Monash-EPHM-Lab/Monash-BoSL/README.md

# Monash-BoSL
Monash-BoSL project repository

This repostory contains all the hardware and software resources for the BoSL board.

Find our website at: www.bosl.com.au

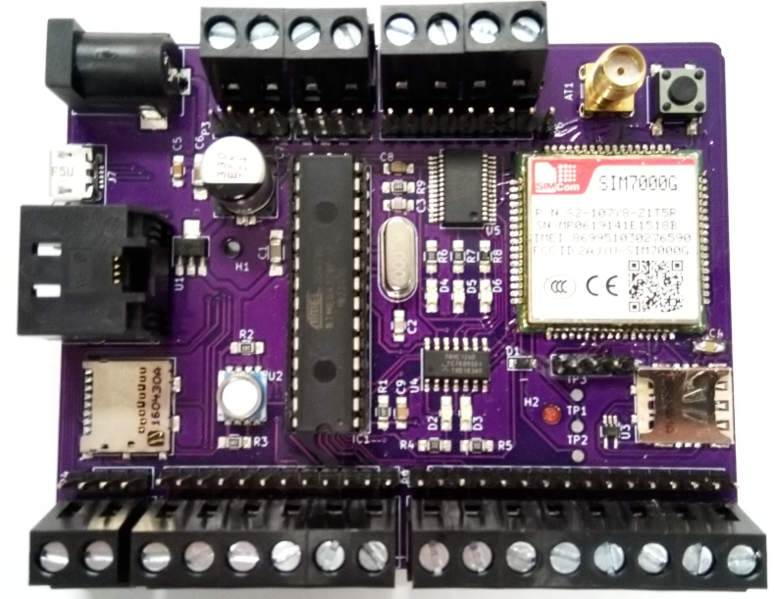
[picture p1: README.png]
BoSL Board
