Monash-EPHM-Lab/Monash-BoSL/Tasklist.txt

Branch Specific Tasklist

measure power consumption on everything and create file for it in documentation.

write code documentation
