Monash-EPHM-Lab/Monash-BoSL/Velocity/FFT/FFT.PNG

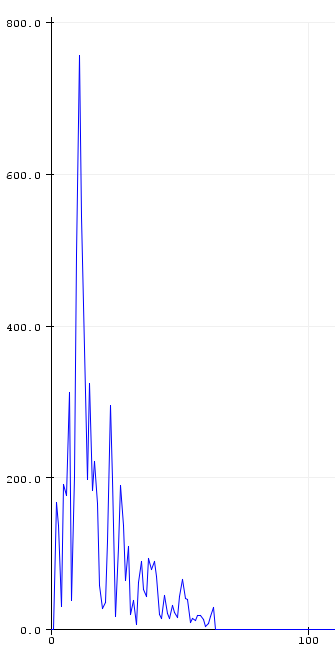
Velocity/FFT/FFT.PNG
