Monash-EPHM-Lab/Monash-BoSL/EDA/BoSL BOM Rev 0.4.1.xlsx

Part Number | Package Size / Type | Schematic Designator | Component | Value | QTY per board | Unit Price | Total Price | Supplier
DC Barrel Jack | 2.1mm | CON2 | DC Barrel Jack | 2.1mm | 1 | $0.50 | $0.50 | https://www.altronics.com.au/p/p0620-2.1mm-female-plastic-pcb-mount-dc-power-socket/
RJ45 Jack |  | J6 | Ethernet Connector |  | 1 | $1.50 | $1.50 | https://au.element14.com/amphenol-icc-commercial-products/rjhse-5080/jack-rj45-1port/dp/1860577?st=RJHSE-5080
Screw Terminals | 5mm pitch | J1 / J2 / J3 / J4 / J5 | Screw Terminals | 1x02 / 2x04 / 1x06 / 1x08 (24 Total) | 24 | $0.30 | $7.20 | https://www.digikey.com.au/product-detail/en/molex/0393570002/WM7877-ND/946543
MCP1700T-3302E | 3-Pin SOT-89 | U1 | Voltage Regulator |  | 1 | $0.60 | $0.60 | https://au.mouser.com/ProductDetail/Microchip-Technology/MCP1700T-3302E-MB
MS5803-01BA |  | U2 | Pressure / Temperature Sensor |  | 1 | $19.00 | $19.00 | https://www.digikey.com/products/es?mpart=MS580301BA01-00&v=223
105133-0001 | Micro | J7 | Micro USB Connector | Vertical | 1 | $0.80 | $0.80 | https://au.element14.com/molex/105133-0001/usb-conn-2-0-micro-usb-type-b/dp/2751682?st=micro usb
FT232RL | SSOP-28 (5.3mm) | U5 | UART to Serial Converter |  | 1 | $4.00 | $4.00 | https://au.mouser.com/ProductDetail/FTDI/FT232RL-REEL?qs=D1%2FPMqvA103RC6OU6bKtoA%3D%3D
74HC126 | SIOC-14 (1.27 mm pitch) | U4 | Quad Tristate Buffer |  | 1 | $0.77 | $0.77 | https://au.element14.com/nexperia/74hc126d/ic-74hc-cmos-smd-74hc126-soic14/dp/1085233?st=74HC126
Any Applicable | 1206 | C1 / C6 | SMD Capacitor | 1 uF | 2 | $0.10 | $0.20
Any Applicable | 0805 | C2 / C3 | SMD Capacitor | 22 pF | 2 | $0.10 | $0.20
Any Applicable | 0805 | C4 | SMD Capacitor | 220 pF | 1 | $0.10 | $0.10
UWT1E331MNL1GS / OR Any Applicable | SMD:CP_Elec_8x10 | C7 | SMD Capacitor | 330 uF | 1 | $0.10 | $0.10 | https://au.mouser.com/ProductDetail/Nichicon/UWT1E331MNL1GS
Any Applicable | 0805 | C5 / C8 / C9 | SMD Capacitor | 100 nF | 3 | $0.10 | $0.30
Any Applicable | 0805 | R1 / R2 / R3 / R9 | SMD Resistor | 10 kΩ | 4 | $0.10 | $0.40
Any Applicable | 0805 | R4 / R5 / R6 / R7 / R8 | SMD Resistor | 3.3 kΩ | 5 | $0.10 | $0.50
1N4148 | D_SOD-323 | D1 | SMD Diode |  | 1 | $0.10 | $0.10
Any Applicable | 0805 | D2 | SMD LED | BLUE | 1 | $0.10 | $0.10
Any Applicable | 0805 | D3 / D4 | SMD LED | RED | 2 | $0.10 | $0.20
Any Applicable | 0805 | D5 | SMD LED | YELLOW | 2 | $0.10 | $0.20
Any Applicable | 0805 | D6 | SMD LED | GREEN | 2 | $0.10 | $0.20
MSQA6V1W5T2G | SOT-353_SC-70-5 | U3 | ESD Protection Diode Array |  | 1 | $1.00 | $1.00 | https://www.digikey.com.au/product-detail/en/on-semiconductor/MSQA6V1W5T2G/MSQA6V1W5T2GOSCT-ND/1967206
Any Applicable | SMD | SW1 | SPST switch |  | 1 | $0.50 | $0.50 | https://www.altronics.com.au/p/s1112a-spst-momentary-smd-4.3mm-tactile-switch/
ECS-80-18-30-JGN-TR | 2-SMD | Y1 | Crystal | 8MHz | 1 | $0.69 | $0.69 | https://www.digikey.com/product-detail/en/ecs-inc/ECS-80-18-30-JGN-TR/XC2103CT-ND/5875587
SIM7000G |  | IC2 | SIM7000 |  | 1 | $19.00 | $19.00 | https://www.aliexpress.com/item/32963816626.html
SIM Card Holder | Nano SIM | I1 | SIM Card Holder |  | 1 | $1.50 | $1.50 | https://au.mouser.com/ProductDetail/Molex/104224-0820
ATMEGA328P-AU | QTFN-32 | U6 | AT Mega 328 P-au |  | 1 | $2.16 | $2.16 | https://www.digikey.com.au/product-detail/en/microchip-technology/ATMEGA328P-AUR/ATMEGA328P-AURCT-ND/3789455
104031-0811 Molex |  | CON1 | microSD connector |  | 1 | $2.50 | $2.50 | https://au.mouser.com/ProductDetail/Molex/104031-0811?qs=sGAEpiMZZMuJakaoiLiBpj1mGp1aVlb8QxJnovvyiw8%3D
 | 0.1 inch pitch | J8 / J9 / J10 / P2 / P3 / P4 | Pin Headers | 3x04 / 1x05 / 1x6 / 1x8
212570-0100 |  | - | GNSS/GSM Antenna |  | 2 | $2.34 | $4.68 | https://au.element14.com/molex/212570-0100/cellular-lte-antenna-2-17ghz-1/dp/326166101?st=antenna
Any Applicable |  | C10 | SMD Capacitor | 33 pF | 1 | $0.10 | $0.10
Any Applicable | 0805 | C11,12 | SMD Capacitor | 12 pF | 2 | $0.10 | $0.20
MCP7940NT-I/SN |  | U7 | RTC Module |  | 1 | $0.74 | $0.74 | https://www.digikey.in/product-detail/en/microchip-technology/MCP7940NT-I-SN/MCP7940NT-I-SNCT-ND/5818704
FC-135 32.7680KA-AG5 |  | Y2 | Crystal | 32.768 kHz | 1 | $0.43 | $0.43 | https://www.digikey.com.au/product-detail/en/epson/FC-135-32-7680KA-AG5/SER4271CT-ND/7932258
2996TR |  | BT1 | Battery Clip |  | 1 | $0.63 | $0.63 | https://www.digikey.com.au/product-detail/en/keystone-electronics/2996TR/36-2996CT-ND/5878110
 | LR44 |  | Button Cell Battery | 1.5 V | 1 | $0.56 | $0.56 | https://www.digikey.com.au/product-detail/en/murata-electronics/LR44/490-18190-ND/9859017
 |  | AT2, AT3 | U.FL Antenna Connector |  | 2 | $0.34 | $0.68 | https://au.mouser.com/ProductDetail/TE-Connectivity/2337019-1
