Monash-EPHM-Lab/Monash-BoSL/Velocity/250kHz/Membrane.stl

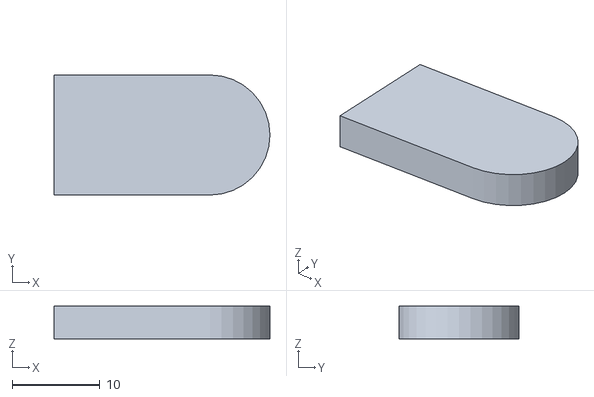
[picture p3: CAD file, 2019-12-09]
Velocity/250kHz/Membrane.stl
24.6 x 13.6 x 3.75
