Monash-EPHM-Lab/Monash-BoSL/Velocity/CAD/Velocity Holder.stl

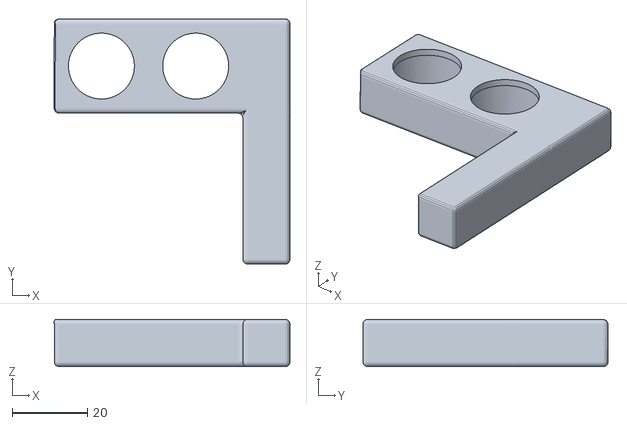
[picture p4: CAD file, 2019-12-10]
Velocity/CAD/Velocity Holder.stl
62.6 x 65.0 x 12.5
