Monash-EPHM-Lab/Monash-BoSL/(list of files, cad)

Other CAD files:
Velocity/250kHz/Membrane.blend
Velocity/CAD/Velocity Holder.blend
Water-Probe/Design Files/CAD/Probe Body Square.blend
