Monash-EPHM-Lab/Monash-BoSL/Documentation/BoSL Battery Log Test.xlsx

Date | Battery (V)
2019-09-26 | 4.05
2019-10-03 | 4.01
2019-10-10 | 3.93
2019-10-17 | 3.9
