Monash-EPHM-Lab/Monash-BoSL/Documentation/Battery Testing/Battery Data.xlsx

BAT 70953 | Temp | EC | Water | Bat | Air | count
2019-12-18 21:16 | -30762 | 183 | 68555 | 4238 | 100676 | 1
2019-12-18 21:18 | -30762 | 183 | 68555 | 4237 | 100553 | 2
2019-12-18 21:21 | -30762 | 183 | 68555 | 4235 | 100709 | 3
2019-12-18 21:23 | -30762 | 183 | 68555 | 4235 | 100688 | 4
2019-12-18 21:26 | -30762 | 176 | 68555 | 4236 | 100700 | 5
2019-12-18 21:28 | 2280 | 1023 | 102059 | 4233 | 100706 | 6
2019-12-18 21:31 | 2279 | 1023 | 102062 | 4232 | 100779 | 7
2019-12-18 21:33 | 2276 | 1023 | 102061 | 4233 | 100773 | 8
2019-12-18 21:36 | 2271 | 1023 | 102073 | 4232 | 100760 | 9
2019-12-18 21:38 | 2267 | 1023 | 102072 | 4231 | 100513 | 10
2019-12-18 21:41 | 2263 | 1023 | 102063 | 4231 | 100821 | 11
2019-12-18 21:43 | 2261 | 1023 | 102065 | 4231 | 100833 | 12
2019-12-18 21:46 | 2258 | 1023 | 102062 | 4230 | 100774 | 13
2019-12-18 21:48 | 2255 | 1023 | 102052 | 4229 | 100798 | 14
2019-12-18 21:51 | 2253 | 1023 | 102042 | 4228 | 100758 | 15
2019-12-18 21:53 | 2251 | 1023 | 102037 | 4229 | 100699 | 16
2019-12-18 21:56 | 2250 | 1023 | 102055 | 4228 | 100739 | 17
2019-12-18 21:58 | -30762 | 180 | 68555 | 4230 | 100801 | 18
2019-12-18 22:01 | -30762 | 179 | 68555 | 4229 | 100753 | 19
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
