Monash-EPHM-Lab/Monash-BoSL/Documentation/Battery Testing/Raw Data/BOSL_BAT_70953.csv

This is our new file for site: BOSL_BAT_70953.csv. We will write Date and time in first column | temperature in the next | EC | then depth
09/12/19 11:25:13 PM | -30762 | 188 | 68555 | 4020 | 100748
18/12/19 09:16:20 PM | -30762 | 183 | 68555 | 4238 | 100676
18/12/19 09:18:49 PM | -30762 | 183 | 68555 | 4237 | 100553
18/12/19 09:21:19 PM | -30762 | 183 | 68555 | 4235 | 100709
18/12/19 09:23:48 PM | -30762 | 183 | 68555 | 4235 | 100688
18/12/19 09:26:17 PM | -30762 | 176 | 68555 | 4236 | 100700
18/12/19 09:28:47 PM | 2280 | 1023 | 102059 | 4233 | 100706
18/12/19 09:31:16 PM | 2279 | 1023 | 102062 | 4232 | 100779
18/12/19 09:33:45 PM | 2276 | 1023 | 102061 | 4233 | 100773
18/12/19 09:36:15 PM | 2271 | 1023 | 102073 | 4232 | 100760
18/12/19 09:38:45 PM | 2267 | 1023 | 102072 | 4231 | 100513
18/12/19 09:41:14 PM | 2263 | 1023 | 102063 | 4231 | 100821
18/12/19 09:43:43 PM | 2261 | 1023 | 102065 | 4231 | 100833
18/12/19 09:46:13 PM | 2258 | 1023 | 102062 | 4230 | 100774
18/12/19 09:48:43 PM | 2255 | 1023 | 102052 | 4229 | 100798
18/12/19 09:51:13 PM | 2253 | 1023 | 102042 | 4228 | 100758
18/12/19 09:53:43 PM | 2251 | 1023 | 102037 | 4229 | 100699
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
