Monash-EPHM-Lab/Monash-BoSL/Documentation/SIM Recognition Issue/SIM Lines/GOOD DATA SIM.jpg

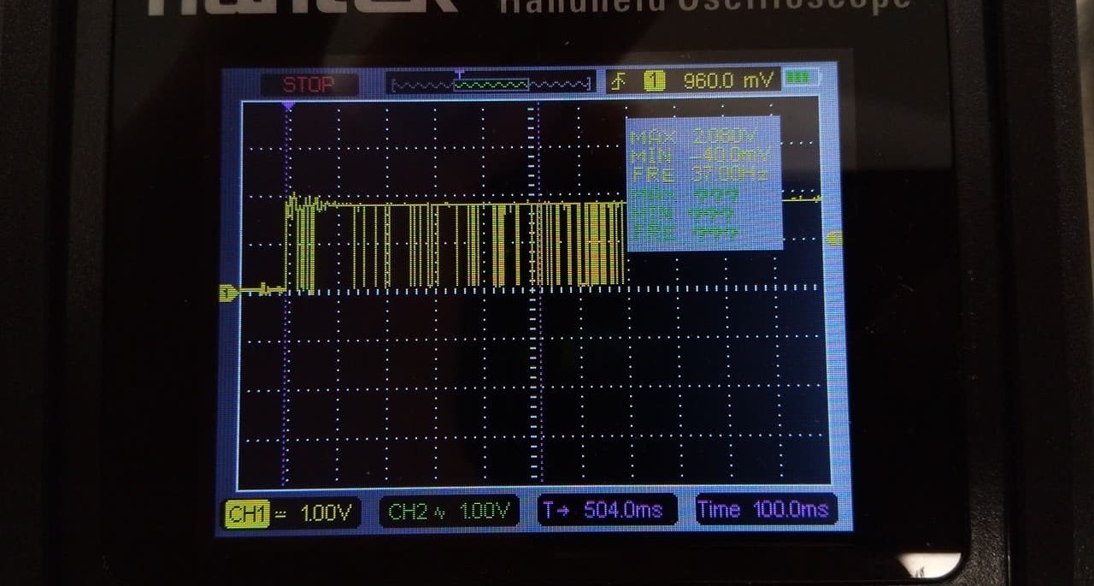
Documentation/SIM Recognition Issue/SIM Lines/GOOD DATA SIM.jpg
