Monash-EPHM-Lab/Monash-BoSL/EDA/BoSL rev0.4.1 schematic.pdf

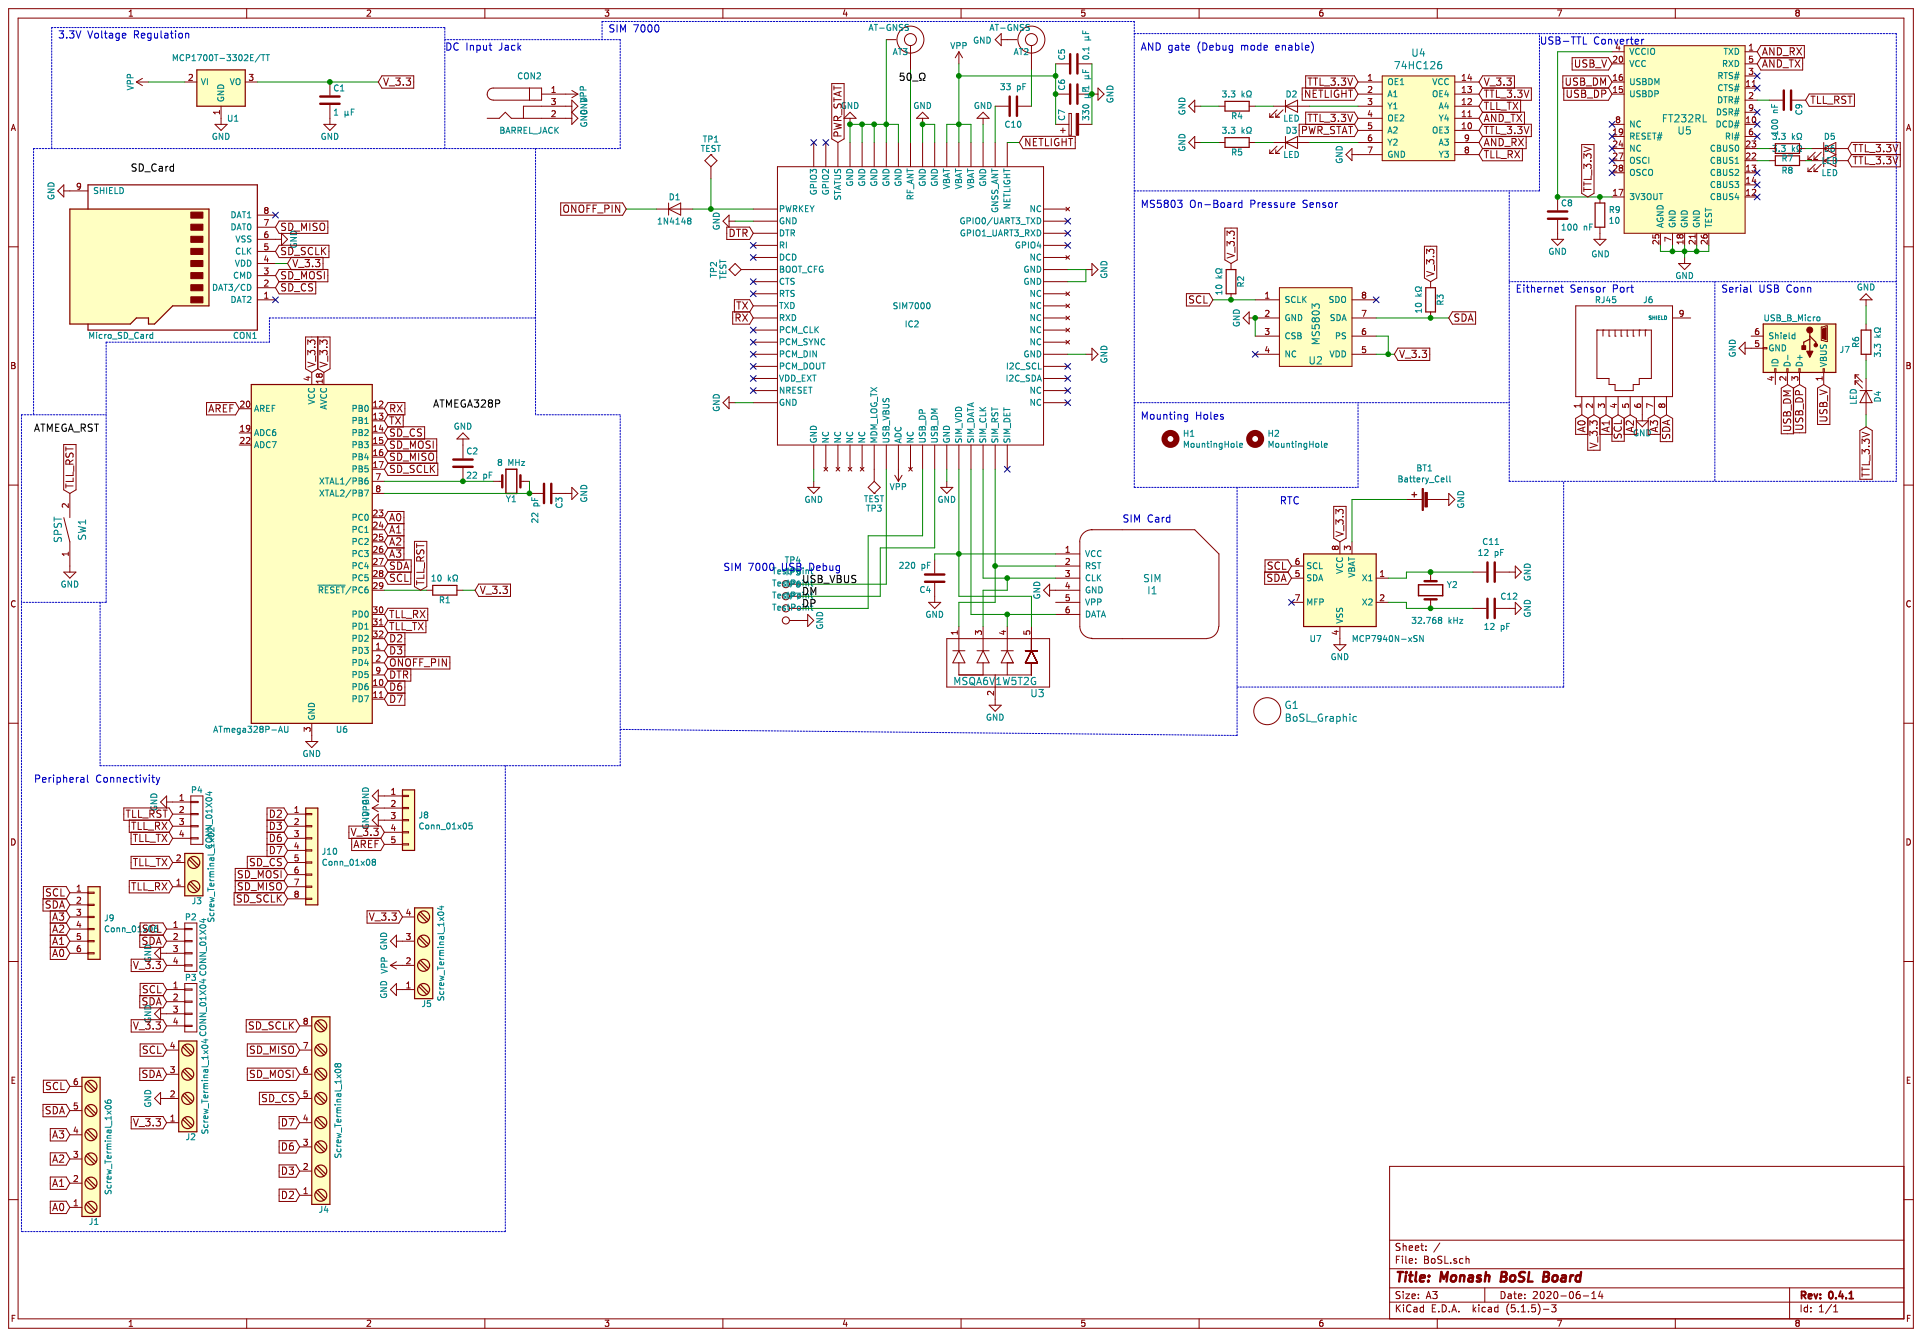
[picture p20: page 1]
