Monash-EPHM-Lab/Monash-BoSL/(list of files, drawings)

Other design files:
EDA/EDA/BoSL.dsn
