Monash-EPHM-Lab/Monash-BoSL/EDA/EDA/BoSL.kicad_pcb

## KiCad design EDA/EDA/BoSL.kicad_pcb (2020-08-11)

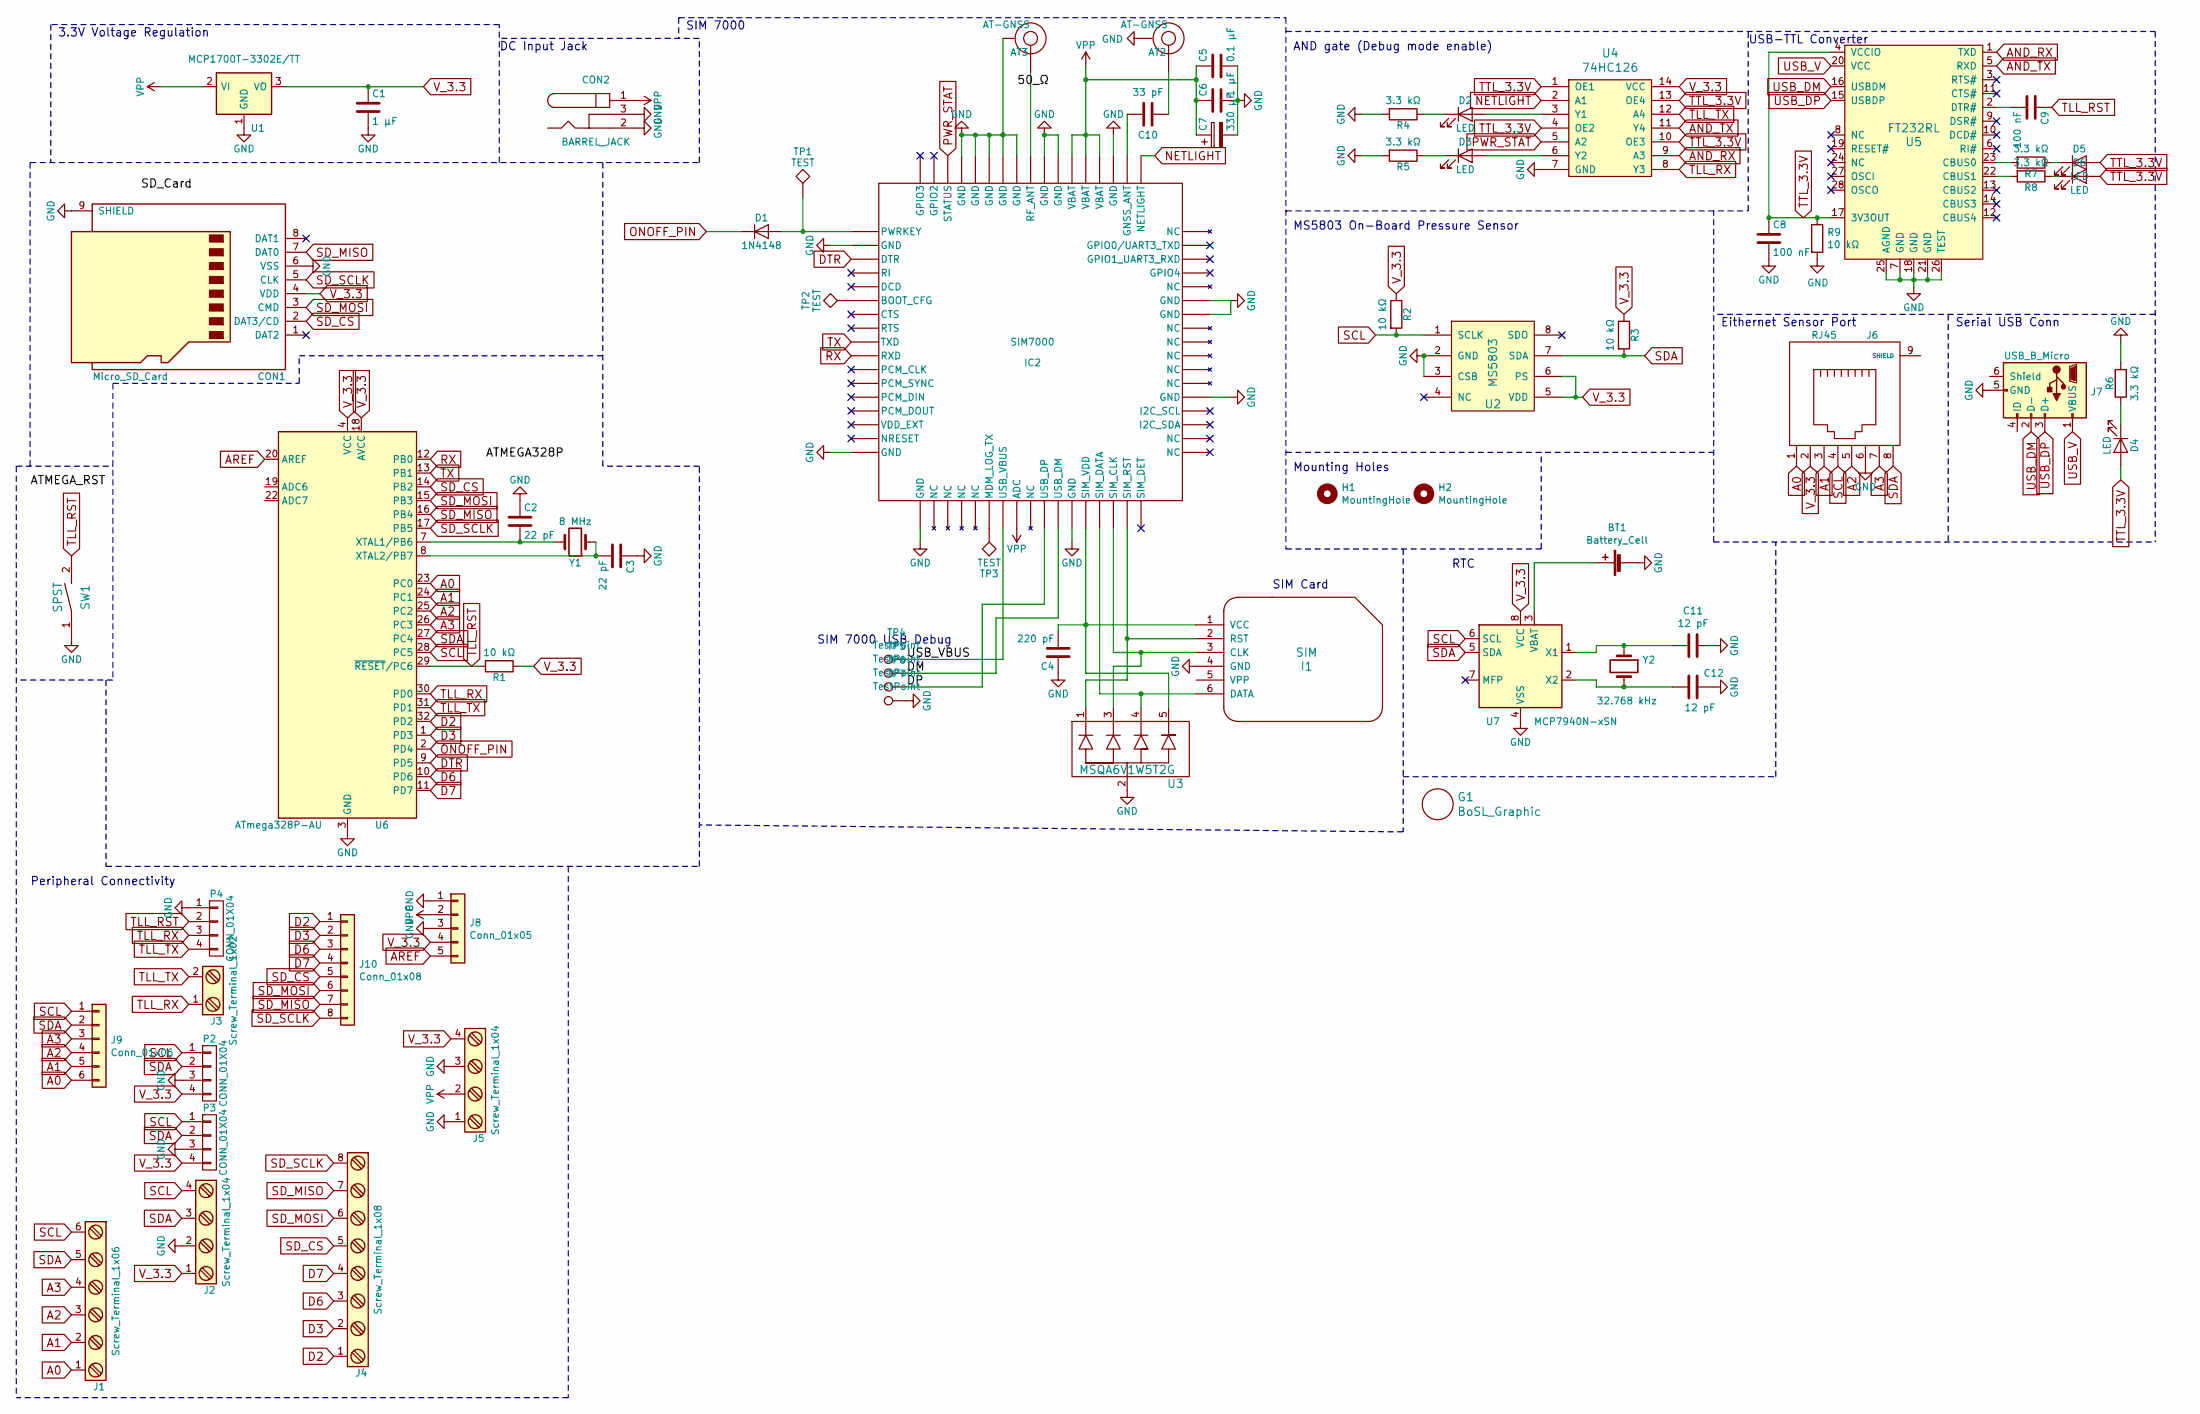
[picture p21: schematic BoSL.sch, Monash BoSL Board]

Parts:
AT2, AT3: AT-GNSS; U.FL_Molex_MCRF_73412-0110_Vertical
BT1: Battery_Cell; 2996TR
C1, C6: 1 μF; C_1206_3216Metric
C2, C3: 22 pF; C_0805_2012Metric
C4: 220 pF; C_0805_2012Metric
C5: 0.1 μF; C_0805_2012Metric
C7: 330 μF; CP_Elec_8x10
C8, C9: 100 nF; C_0805_2012Metric
C10: 33 pF; C_0805_2012Metric
C11, C12: 12 pF; C_0805_2012Metric
CON1: Micro_SD_Card; microSD_Connector
CON2: BARREL_JACK; BarrelJack_Horizontal
D1: 1N4148; D_SOD-323
D2, D3, D4, D5, D6: LED; LED_0805_2012Metric
G1: BoSL_Graphic
H1, H2: MountingHole; MountingHole_2.2mm_M2_Pad
I1: SIM; SIMNano
IC2: SIM7000
J1: Screw_Terminal_1x06; TerminalBlock_Phoenix_PT-1,5-6-3.5-H_1x06_P3.50mm_Horizontal
J2, J5: Screw_Terminal_1x04; TerminalBlock_Phoenix_PT-1,5-4-3.5-H_1x04_P3.50mm_Horizontal
J3: Screw_Terminal_1x02; TerminalBlock_Phoenix_PT-1,5-2-3.5-H_1x02_P3.50mm_Horizontal
J4: Screw_Terminal_1x08; TerminalBlock_Phoenix_PT-1,5-8-3.5-H_1x08_P3.50mm_Horizontal
J6: RJ45; RJ_45
J7: USB_B_Micro; USB_Micro-B_Molex-105133-0001
J8: Conn_01x05; PinHeader_1x05_P2.54mm_Vertical
J9: Conn_01x06; PinHeader_1x06_P2.54mm_Vertical
J10: Conn_01x08; PinHeader_1x08_P2.54mm_Vertical
P2, P3, P4: CONN_01X04; PinHeader_1x04_P2.54mm_Vertical
R1, R2, R3, R9: 10 kΩ; R_0805_2012Metric
R4, R5, R6, R7, R8: 3.3 kΩ; R_0805_2012Metric
SW1: SPST; SW_SPST_B3S-1000
TP1, TP2, TP3: TEST; TestPoint_Pad_D1.0mm
TP4, TP5, TP6, TP7: TestPoint; TestPoint_Pad_1.5x1.5mm
U1: MCP1700T-3302E/TT; SOT-89-3
U2: MS5803
U3: MSQA6V1W5T2G; SOT-353_SC-70-5
U4: 74HC126; SOIC-14_3.9x8.7mm_P1.27mm
U5: FT232RL; SSOP-28_5.3x10.2mm_P0.65mm
U6: ATmega328P-AU; TQFP-32_7x7mm_P0.8mm
U7: MCP7940N-xSN; SOIC-8_3.9x4.9mm_P1.27mm
Y1: 8 MHz; Crystal_SMD_5032-2Pin_5.0x3.2mm
Y2: 32.768 kHz; Crystal_SMD_EuroQuartz_EQ161-2Pin_3.2x1.5mm

Connections:
/DM: IC2.28 (USB_DM), TP5.1
/DP: IC2.27 (USB_DP), TP6.1
/USB_VBUS: IC2.24 (USB_VBUS), TP4.1
A0: J1.1, J6.1, J9.6, U6.23 (PC0)
A1: J1.2, J6.3, J9.5, U6.24 (PC1)
A2: J1.3, J6.5, J9.4, U6.25 (PC2)
A3: J1.4, J6.7, J9.3, U6.26 (PC3)
AND_RX: U4.9 (A3), U5.1 (TXD)
AND_TX: U4.11 (Y4), U5.5 (RXD)
AREF: J8.5, U6.20 (AREF)
D2: J4.1, J10.1, U6.32 (PD2)
D3: J4.2, J10.2, U6.1 (PD3)
D6: J4.3, J10.3, U6.10 (PD6)
D7: J4.4, J10.4, U6.11 (PD7)
DTR: IC2.3 (DTR), U6.9 (PD5)
GND: AT2.2, AT3.2, BT1.2 (-), C1.2, C2.1, C3.1, C4.1, C5.2, C6.2, C7.2, C8.2, C11.1, C12.1, CON1.6 (VSS), CON1.9 (SHIELD), CON2.2, CON2.3, I1.4 (GND), IC2.2 (GND), IC2.17 (GND), IC2.18 (GND), IC2.29 (GND), IC2.39 (GND), IC2.45 (GND), IC2.46 (GND), IC2.54 (GND), IC2.58 (GND), IC2.59 (GND), IC2.61 (GND), IC2.62 (GND), IC2.63 (GND), IC2.64 (GND), IC2.65 (GND), J2.2, J5.1, J5.3, J6.6, J7.5 (GND), J8.1, J8.3, P2.3, P3.3, P4.1, R4.2, R5.2, R6.2, R9.2, SW1.1, TP7.1, U1.1 (GND), U2.2 (GND), U2.3 (CSB), U3.2, U4.7 (GND), U5.7 (GND), U5.18 (GND), U5.21 (GND), U5.25 (AGND), U5.26 (TEST), U6.3 (GND), U6.5 (GND), U6.21 (GND), U7.4 (VSS)
NETLIGHT: IC2.52 (NETLIGHT), U4.2 (A1)
unnamed: AT2.1, C10.1
unnamed: AT3.1, IC2.60 (RF_ANT)
unnamed: BT1.1 (+), U7.3 (VBAT)
unnamed: C2.2, U6.7 (XTAL1/PB6), Y1.2
unnamed: C3.2, U6.8 (XTAL2/PB7), Y1.1
unnamed: C4.2, I1.1 (VCC), IC2.30 (SIM_VDD), U3.5
unnamed: C9.2, U5.2 (DTR#)
unnamed: C10.2, IC2.53 (GNSS_ANT)
unnamed: C11.2, U7.1 (X1), Y2.1
unnamed: C12.2, U7.2 (X2), Y2.2
unnamed: D1.2 (A), IC2.1 (PWRKEY), TP1.1
unnamed: D2.1 (K), R4.1
unnamed: D2.2 (A), U4.3 (Y1)
unnamed: D3.1 (K), R5.1
unnamed: D3.2 (A), U4.6 (Y2)
unnamed: D4.1 (K), R6.1
unnamed: D5.1 (K), R7.1
unnamed: D6.1 (K), R8.1
unnamed: I1.2 (RST), IC2.33 (SIM_RST), U3.1
unnamed: I1.3 (CLK), IC2.32 (SIM_CLK), U3.3
unnamed: I1.6 (DATA), IC2.31 (SIM_DATA), U3.4
unnamed: IC2.6 (BOOT_CFG), TP2.1
unnamed: IC2.23 (MDM_LOG_TX), TP3.1
unnamed: R7.2, U5.23 (CBUS0)
unnamed: R8.2, U5.22 (CBUS1)
ONOFF_PIN: D1.1 (K), U6.2 (PD4)
PWR_STAT: IC2.66 (STATUS), U4.5 (A2)
RX: IC2.10 (RXD), U6.12 (PB0)
SCL: J1.6, J2.4, J6.4, J9.1, P2.1, P3.1, R2.2, U2.1 (SCLK), U6.28 (PC5), U7.6 (SCL)
SDA: J1.5, J2.3, J6.8, J9.2, P2.2, P3.2, R3.2, U2.7 (SDA), U6.27 (PC4), U7.5 (SDA)
SD_CS: CON1.2 (DAT3/CD), J4.5, J10.5, U6.14 (PB2)
SD_MISO: CON1.7 (DAT0), J4.7, J10.7, U6.16 (PB4)
SD_MOSI: CON1.3 (CMD), J4.6, J10.6, U6.15 (PB3)
SD_SCLK: CON1.5 (CLK), J4.8, J10.8, U6.17 (PB5)
TLL_RST: C9.1, P4.2, R1.2, SW1.2, U6.29 (~RESET~/PC6)
TLL_RX: J3.1, P4.3, U4.8 (Y3), U6.30 (PD0)
TLL_TX: J3.2, P4.4, U4.12 (A4), U6.31 (PD1)
TTL_3.3V: C8.1, D4.2 (A), D5.2 (A), D6.2 (A), R9.1, U4.1 (OE1), U4.4 (OE2), U4.10 (OE3), U4.13 (OE4), U5.4 (VCCIO), U5.17 (3V3OUT)
TX: IC2.9 (TXD), U6.13 (PB1)
USB_DM: J7.2 (D-), U5.16 (USBDM)
USB_DP: J7.3 (D+), U5.15 (USBDP)
USB_V: J7.1 (VBUS), U5.20 (VCC)
VPP: C5.1, C6.1, C7.1, CON2.1, IC2.25 (ADC), IC2.55 (VBAT), IC2.56 (VBAT), IC2.57 (VBAT), J5.2, J8.2, U1.2 (VI)
V_3.3: C1.1, CON1.4 (VDD), J2.1, J5.4, J6.2, J8.4, P2.4, P3.4, R1.1, R2.1, R3.1, U1.3 (VO), U2.5 (VDD), U2.6 (PS), U4.14 (VCC), U6.4 (VCC), U6.6 (VCC), U6.18 (AVCC), U7.8 (VCC)

Notes on the sheet:
3.3V Voltage Regulation
DC Input Jack
SIM 7000
SIM Card
SIM 7000 USB Debug
AND gate (Debug mode enable)
USB-TTL Converter
Serial USB Conn
Eithernet Sensor Port
MS5803 On-Board Pressure Sensor
Peripheral Connectivity
Mounting Holes
RTC

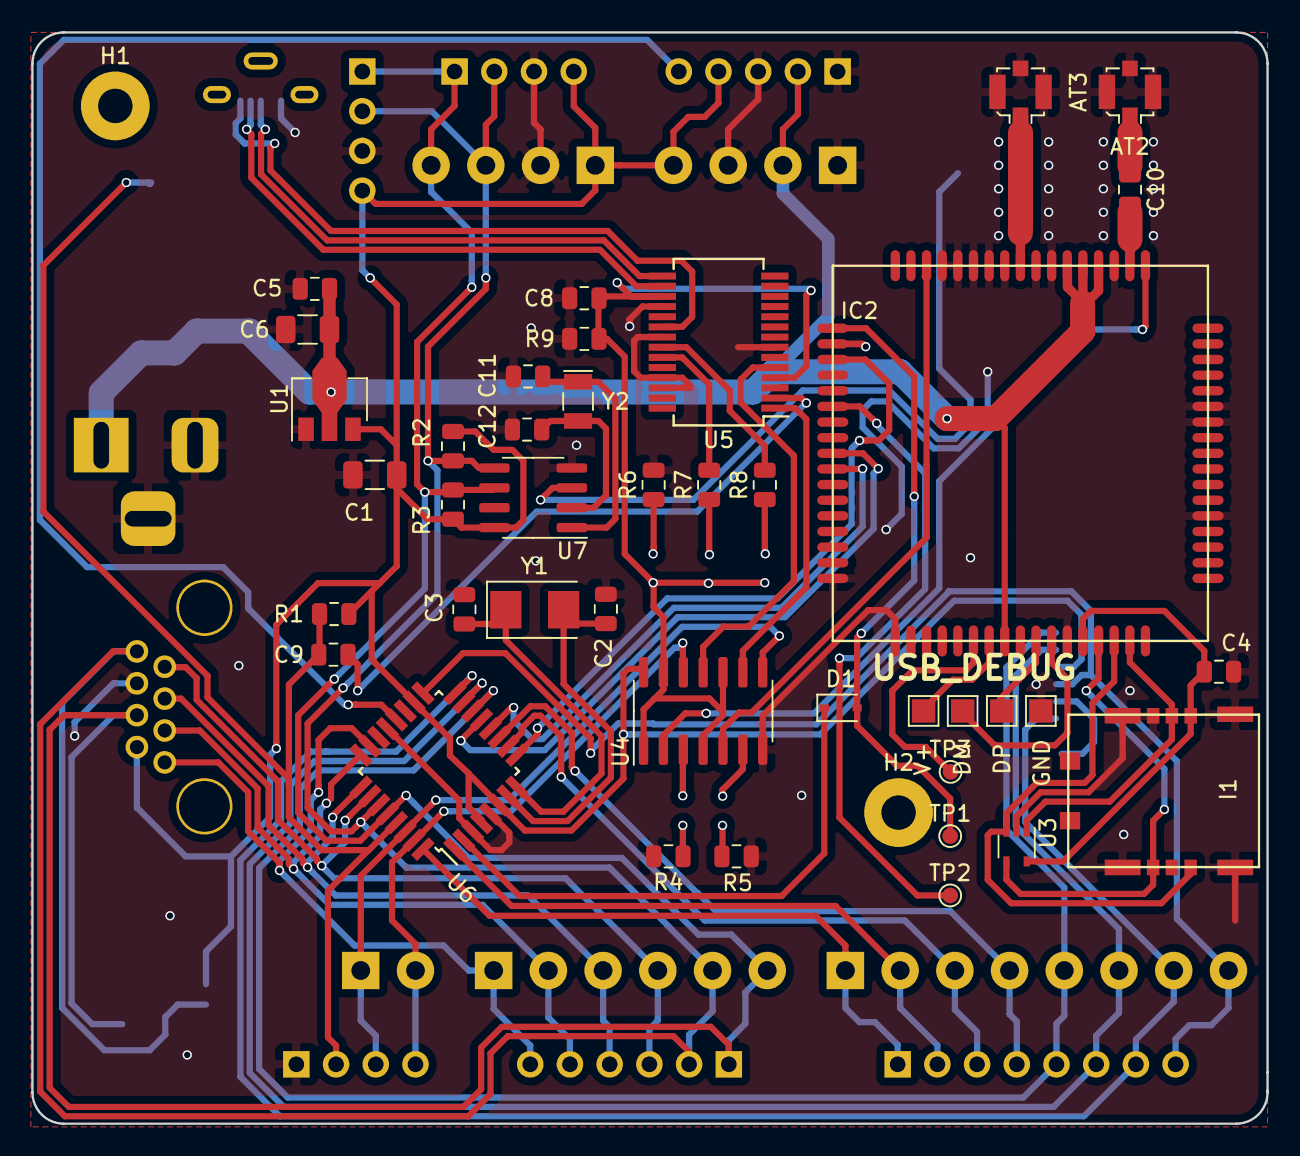
[picture p22: board BoSL.kicad_pcb from above]

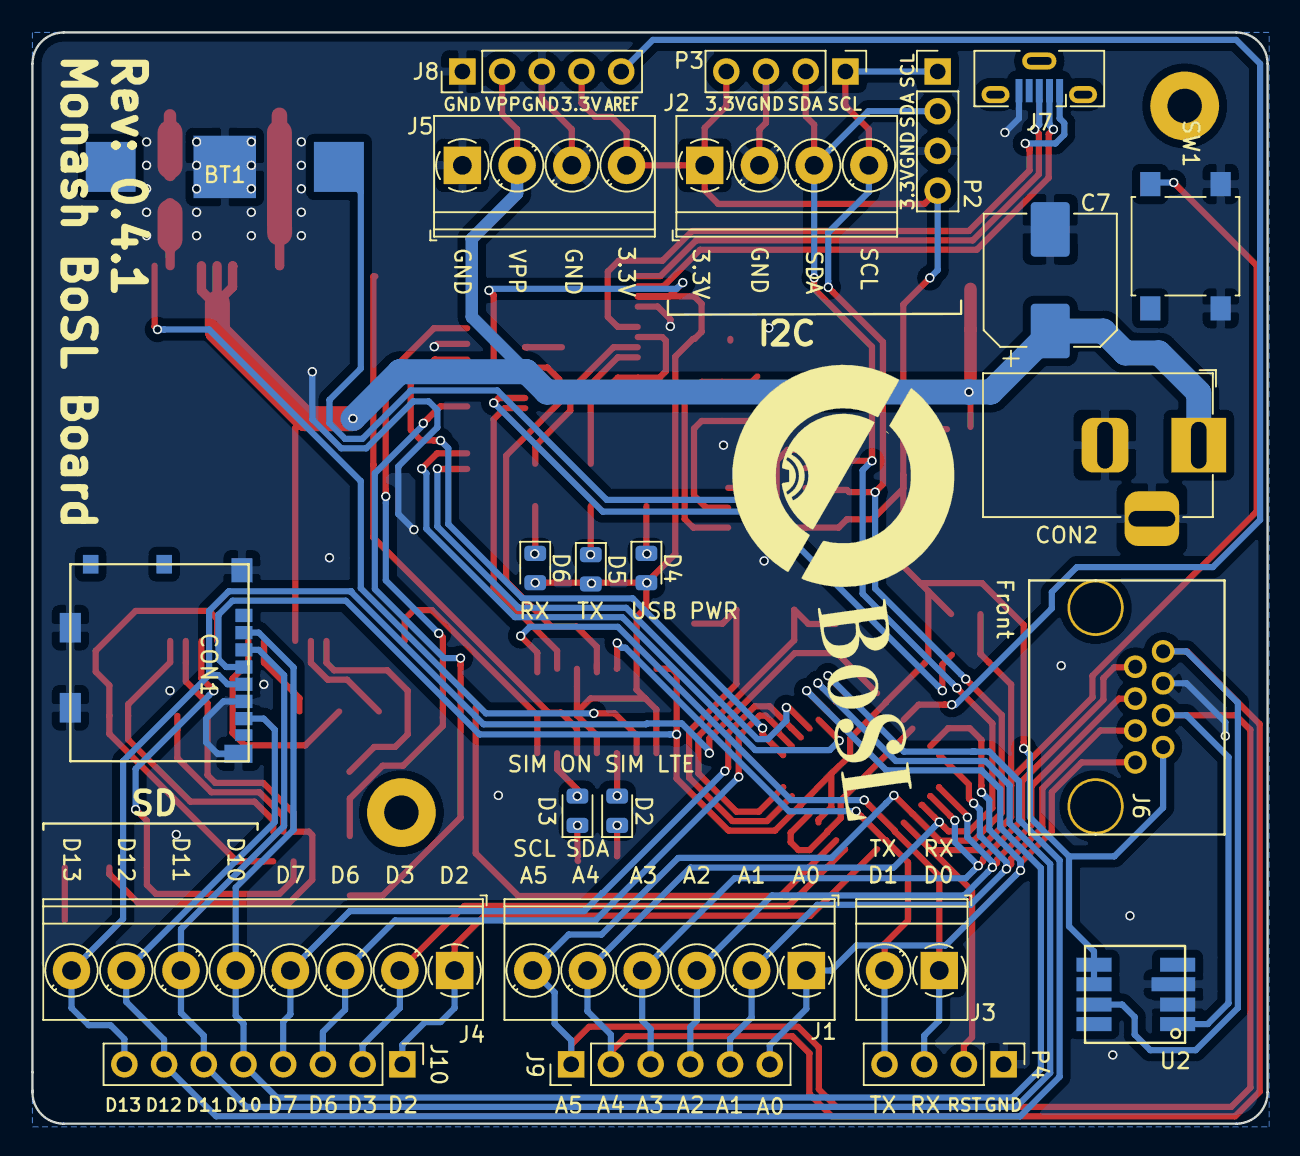
[picture p23: board BoSL.kicad_pcb from below]

Board: 2 copper layers, 79.0 x 69.8 mm, 67 parts (25 on the bottom side), 61 nets.
