Monash-EPHM-Lab/Monash-BoSL/Velocity/AM Demodulator/AM Demodulator/AM Demodulator.kicad_pcb

## KiCad design Velocity/AM Demodulator/AM Demodulator/AM Demodulator.kicad_pcb (2019-12-09)

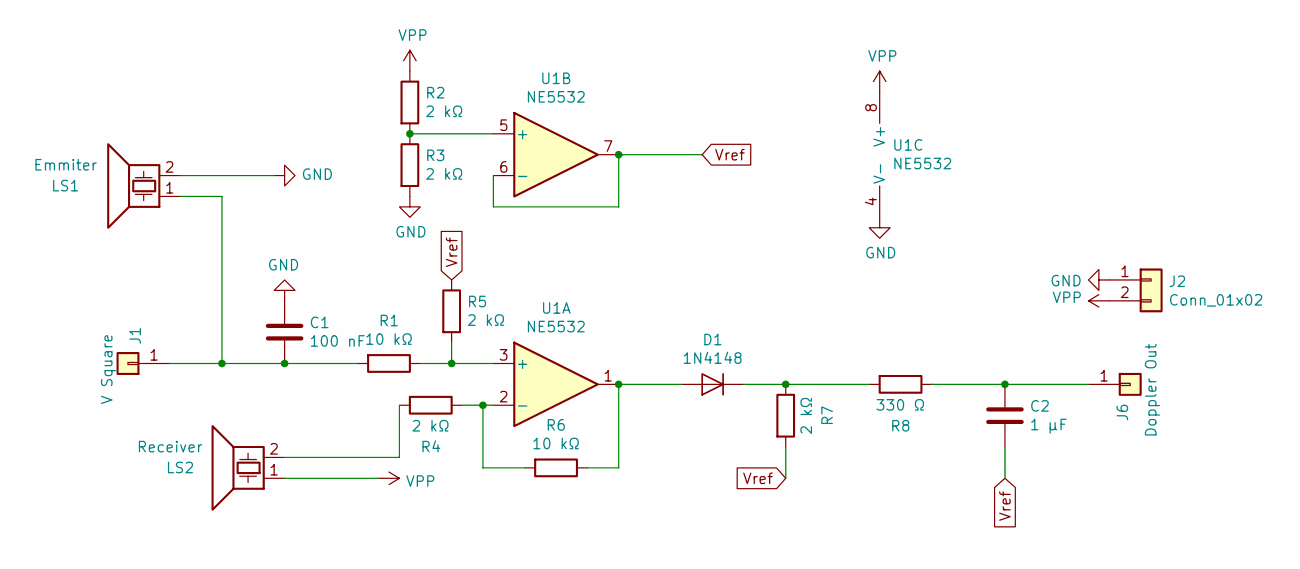
[picture p24: schematic AM Demodulator.sch, Velocity AM Demodulator]

Parts:
C1: 100 nF; CP_Radial_D5.0mm_P2.50mm
C2: 1 μF; CP_Radial_D5.0mm_P2.50mm
D1: 1N4148; D_A-405_P7.62mm_Horizontal
J1: V Square; Pin_Header_Straight_1x01_Pitch2.54mm
J2: Conn_01x02; Pin_Header_Straight_1x02_Pitch2.54mm
J6: Doppler Out; Pin_Header_Straight_1x01_Pitch2.54mm
LS1: Emmiter; Pin_Header_Straight_1x02_Pitch2.54mm
LS2: Receiver; Pin_Header_Straight_1x02_Pitch2.54mm
R1, R6: 10 kΩ; R_Axial_DIN0204_L3.6mm_D1.6mm_P7.62mm_Horizontal
R2, R3, R4, R5, R7: 2 kΩ; R_Axial_DIN0204_L3.6mm_D1.6mm_P7.62mm_Horizontal
R8: 330 Ω; R_Axial_DIN0204_L3.6mm_D1.6mm_P7.62mm_Horizontal
U1: NE5532; DIP-8_W7.62mm_LongPads

Connections:
GND: C1.1, J2.1, LS1.2, R3.2, U1.4 (V-)
unnamed: C1.2, J1.1, LS1.1, R1.2
unnamed: C2.1, J6.1, R8.1
unnamed: D1.1 (K), R7.1, R8.2
unnamed: D1.2 (A), R6.1, U1.1
unnamed: LS2.2, R4.2
unnamed: R1.1, R5.2, U1.3 (+)
unnamed: R2.2, R3.1, U1.5 (+)
unnamed: R4.1, R6.2, U1.2 (-)
VPP: J2.2, LS2.1, R2.1, U1.8 (V+)
Vref: C2.2, R5.1, R7.2, U1.6 (-), U1.7

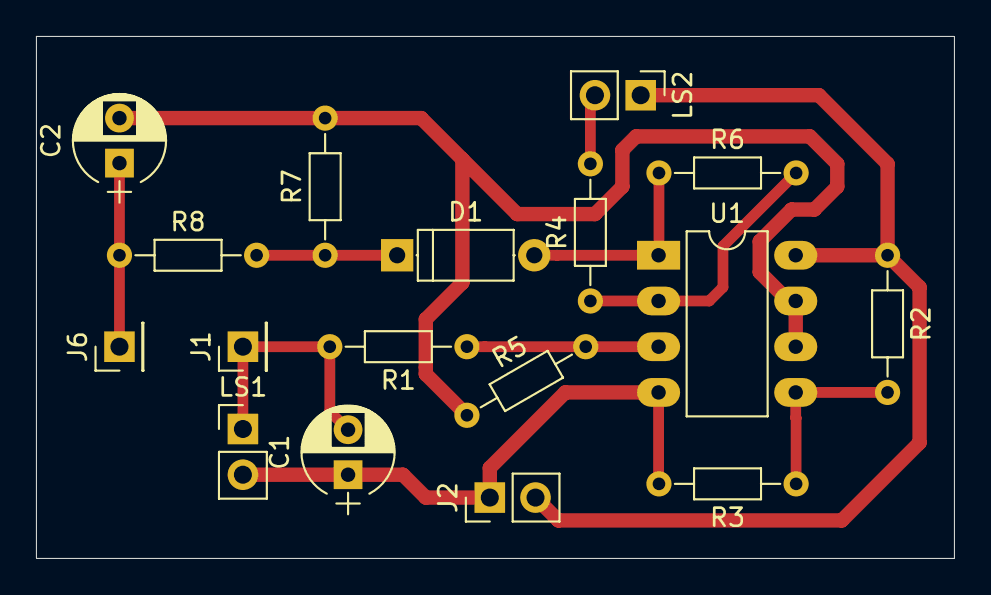
[picture p25: board AM Demodulator.kicad_pcb from above]

Board: 2 copper layers, 51.0 x 29.0 mm, 17 parts (0 on the bottom side), 11 nets.
