Monash-EPHM-Lab/Monash-BoSL/Code/BoSL-lib/SIM7000.h

/***************************************************
  This is a library for our Adafruit FONA Cellular Module

  Designed specifically to work with the Adafruit FONA
  ----> http://www.adafruit.com/products/1946
  ----> http://www.adafruit.com/products/1963

  These displays use TTL Serial to communicate, 2 pins are required to
  interface
  Adafruit invests time and resources providing this open source code,
  please support Adafruit and open-source hardware by purchasing
  products from Adafruit!

  Written by Limor Fried/Ladyada for Adafruit Industries.
  BSD license, all text above must be included in any redistribution
 ****************************************************/
#ifndef SIM7000_H
#define SIM7000_H

#include "includes/FONAConfig.h"
#include "includes/FONAExtIncludes.h"
#include "includes/platform/FONAPlatform.h"


#define FONA_DEFAULT_TIMEOUT_MS 500

#define FONA_HTTP_GET   0
#define FONA_HTTP_POST  1
#define FONA_HTTP_HEAD  2


class SIM7000 : public FONAStreamType {
 public:
  SIM7000(void);

  boolean begin(FONAStreamType &port);

  // Stream
  int available(void);
  size_t write(uint8_t x);
  int read(void);
  int peek(void);
  void flush();

  // Power, battery, and ADC
  boolean powerDown(void);
  boolean getADCVoltage(uint16_t *v);
  boolean getBattPercent(uint16_t *p);
  boolean getBattVoltage(uint16_t *v);

  // Functionality and operation mode settings
  boolean setFunctionality(uint8_t option); // AT+CFUN command
  boolean enableSleepMode(bool onoff); // AT+CSCLK command
  boolean set_eDRX(uint8_t mode, uint8_t connType, char * eDRX_val); // AT+CEDRXS command
  boolean enablePSM(bool onoff); // AT+CPSMS command
  boolean setNetLED(bool onoff, uint8_t mode = 0, uint16_t timer_on = 64, uint16_t timer_off = 3000); // AT+CNETLIGHT and AT+SLEDS commands

  // SIM query
  uint8_t unlockSIM(char *pin);
  uint8_t getSIMCCID(char *ccid);
  uint8_t getNetworkStatus(void);
  uint8_t getRSSI(void);

  // IMEI
  uint8_t getIMEI(char *imei);

  // Time
  // boolean enableNetworkTimeSync(boolean onoff);
  boolean enableNTPTimeSync(boolean onoff, FONAFlashStringPtr ntpserver=0);
  boolean getTime(char *buff, uint16_t maxlen);
  
  // RTC
  boolean enableRTC(uint8_t i);

  // GPRS handling
  boolean enableGPRS(boolean onoff);
  void setNetworkSettings(FONAFlashStringPtr apn, FONAFlashStringPtr username=0, FONAFlashStringPtr password=0);
  void getNetworkInfo(void);

  boolean postData(const char *request_type, const char *URL, const char *body = "", const char *token = "", uint32_t bodylen = 0);

  // TCP raw connections
  boolean TCPconnect(char *server, uint16_t port);
  boolean TCPclose(void);
  boolean TCPconnected(void);
  boolean TCPsend(char *packet, uint8_t len);
  uint16_t TCPavailable(void);
  uint16_t TCPread(uint8_t *buff, uint8_t len);

  // Helper functions to verify responses.
  boolean expectReply(FONAFlashStringPtr reply, uint16_t timeout = 10000);
  boolean sendCheckReply(const char *send, const char *reply, uint16_t timeout = FONA_DEFAULT_TIMEOUT_MS);
  boolean sendCheckReply(FONAFlashStringPtr send, FONAFlashStringPtr reply, uint16_t timeout = FONA_DEFAULT_TIMEOUT_MS);
  boolean sendCheckReply(const char* send, FONAFlashStringPtr reply, uint16_t timeout = FONA_DEFAULT_TIMEOUT_MS);

//////////////////////
//LTE METHODS - SIM7000
  boolean setPreferredMode(uint8_t mode);
  boolean setPreferredLTEMode(uint8_t mode);
  boolean setOperatingBand(const char * mode, uint8_t band);
  boolean setBaudrate(uint16_t baud);


 protected:
  char replybuffer[200];
  FONAFlashStringPtr apn;
  FONAFlashStringPtr useragent;
  FONAFlashStringPtr ok_reply;

  void flushInput();
  uint16_t readRaw(uint16_t b);
  uint8_t readline(uint16_t timeout = FONA_DEFAULT_TIMEOUT_MS, boolean multiline = false);
  uint8_t getReply(const char *send, uint16_t timeout = FONA_DEFAULT_TIMEOUT_MS);
  uint8_t getReply(FONAFlashStringPtr send, uint16_t timeout = FONA_DEFAULT_TIMEOUT_MS);
  uint8_t getReply(FONAFlashStringPtr prefix, char *suffix, uint16_t timeout = FONA_DEFAULT_TIMEOUT_MS);
  uint8_t getReply(FONAFlashStringPtr prefix, int32_t suffix, uint16_t timeout = FONA_DEFAULT_TIMEOUT_MS);
  uint8_t getReply(FONAFlashStringPtr prefix, int32_t suffix1, int32_t suffix2, uint16_t timeout); // Don't set default value or else function call is ambiguous.
  uint8_t getReplyQuoted(FONAFlashStringPtr prefix, FONAFlashStringPtr suffix, uint16_t timeout = FONA_DEFAULT_TIMEOUT_MS);

  boolean sendCheckReply(FONAFlashStringPtr prefix, char *suffix, FONAFlashStringPtr reply, uint16_t timeout = FONA_DEFAULT_TIMEOUT_MS);
  boolean sendCheckReply(FONAFlashStringPtr prefix, int32_t suffix, FONAFlashStringPtr reply, uint16_t timeout = FONA_DEFAULT_TIMEOUT_MS);
  boolean sendCheckReply(FONAFlashStringPtr prefix, int32_t suffix, int32_t suffix2, FONAFlashStringPtr reply, uint16_t timeout = FONA_DEFAULT_TIMEOUT_MS);
  boolean sendCheckReplyQuoted(FONAFlashStringPtr prefix, FONAFlashStringPtr suffix, FONAFlashStringPtr reply, uint16_t timeout = FONA_DEFAULT_TIMEOUT_MS);

  boolean parseReply(FONAFlashStringPtr toreply, uint16_t *v, char divider  = ',', uint8_t index=0);
  boolean parseReplyFloat(FONAFlashStringPtr toreply, float *f, char divider, uint8_t index);
  boolean parseReply(FONAFlashStringPtr toreply, char *v, char divider  = ',', uint8_t index=0);
  boolean parseReplyQuoted(FONAFlashStringPtr toreply, char *v, int maxlen, char divider, uint8_t index);

  boolean sendParseReply(FONAFlashStringPtr tosend, FONAFlashStringPtr toreply, uint16_t *v, char divider = ',', uint8_t index=0);
  boolean sendParseReplyFloat(FONAFlashStringPtr tosend, FONAFlashStringPtr toreply, float *f, char divider = ',', uint8_t index=0);

  FONAStreamType *mySerial;
};


#endif
