Monash-EPHM-Lab/Monash-BoSL/(commit log)

2019-04-03 Organised arduino files so can be uploaded to arduino
2019-04-04 Modified Aruino code to upload battery data once an hour
2019-04-11 Began Cleaning up code Added begginings of classes for future implementation
    [Example Data.csv]
2019-05-01 Switched power pins of ec from analogue to ground
2019-05-01 push prior to ec debug, implemented ec polarity switching
2019-05-02 realease candiate for polarity switching on EC, code to be tested in lab
2019-05-02 arrays created in SensorData library
2019-05-16 added lib files which belong in Arduino libraries folder.
2019-05-16 added print method on sensor data class
2019-05-22 updated sensor data to print transmited values
2019-05-23 made some improvements and additions. Need to lab test EC sensor
2019-06-15 reworked sensordata arrays and added saving. not tested yet
2019-07-18 modified EC to return resistance on probe conducivity is probe specific and would need to be calibrated calibration values added suggested calibration method: - short probe and adjust Rcable untill g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
2019-07-21 Resolved merge conflicts manually
    [SensorEC.cpp, SensorEC.h]
2019-07-22 Calibrated EC with lab measured samples
2019-07-23 calibrated EC sensors
2019-08-14 added low current measured (in other script) sleep mode
2019-08-15 tested version working with BoSL board v0.1
2019-08-16 fixed to power testing
2019-09-24 added board and sensor probe files
    [BoSL BOM Rev 0.3.xlsx, BoSL Probe.kicad_pcb, BoSL Probe.sch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]
2019-09-24 rearranging directories
    [BoSL BOM Rev 0.3.xlsx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]
2019-09-25 fixed mesh of water probe body
    [Probe Body.blend]
2019-09-26 commit before reshaping sensor body to have depth probe at botton
    [Probe Body Square.blend, Probe Body.blend]
2019-09-26 finished modeling probe shape
    [BoSL Probe.kicad_pcb, Probe Body Square.blend]
2019-09-26 added renderings of probe
    [Probe Body Square.blend]
2019-09-26 commiting pcb changes for probe
    [BoSL Probe.sch]
2019-10-03 keystone rightangle screw connectors added
    [BoSL Probe.kicad_pcb, Probe Body.blend]
2019-10-03 commit before adding perferations to probe
    [BoSL Probe.kicad_pcb, BoSL Probe.sch, Keystone_Screw.blend, Keystone_Screw_Small.blend, Probe Body Square.blend]
2019-10-03 added rendering of probe
    [BoSL Probe.kicad_pcb, Probe Body Square.blend]
2019-10-03 added parts list finished rendering dimentions
    [Probe Body Square.blend]
2019-10-03 cleaned up folder strucutre eg: deleted .DS_store files added power info document for bosl board
    [Battery Calulator.xlsx, BoSL Battery Log Test.xlsx, BoSL-Probe BOM.xlsx, Probe Body Square.blend, Probe Body Square.stl]
2019-10-09 added data point for BoSL battery monitering
    [BoSL Battery Log Test.xlsx]
2019-10-09 changed ec drum to oval to reduce flow height needed for good ec reading
    [Probe Body Small EC.stl, Probe Body Square.blend]
2019-10-10 adding rev 0.1 of sensor board pcb
    [BoSL Probe-B_Cu.gbr, BoSL Probe-B_Mask.gbr, BoSL Probe-B_Paste.gbr, BoSL Probe-B_SilkS.gbr, BoSL Probe-Edge_Cuts.gbr, BoSL Probe-F_Cu.gbr, BoSL Probe-F_Mask.gbr, BoSL Probe-F_Paste.gbr]
2019-10-10 added gcode files for 3d printing of sensor probe
2019-10-10 added pcb renders
    [Probe Body Square.stl, Probe Body.blend]
2019-10-14 added v8 stl file for water probe body from Dave
    [Probe Body Small EC.stl, Probe Body v8.stl]
2019-10-16 added datapoint for BoSL02 test
    [BoSL Battery Log Test.xlsx, BoSL-Probe BOM.xlsx]
2019-10-31 fixed branch commit error
    [Probe Body.blend]
2019-11-01 changed footprint of rj45, courtyard expanded and fixed added bosl GSP version
    [BoSL_GSP.dsn, BoSL_GSP.kicad_pcb, BoSL_GSP.sch]
2019-11-01 generated bosl gsp gerber files and bom
    [BoSL BOM Rev 0.3 GSP.xlsx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]
2019-11-13 changed footprints to accomodate part
2019-11-15 changed probe EC footprint to screw terminal cleaned up bosl GPS code
    [BoSL Probe-B_Cu.gbr, BoSL Probe-B_Mask.gbr, BoSL Probe-B_Paste.gbr, BoSL Probe-B_SilkS.gbr, BoSL Probe-Edge_Cuts.gbr, BoSL Probe-F_Cu.gbr, BoSL Probe-F_Mask.gbr, BoSL Probe-F_Paste.gbr]
2019-11-18 transmit code added to gps
    [BoSL Probe-B_Cu.gbr, BoSL Probe-B_Mask.gbr, BoSL Probe-B_Paste.gbr, BoSL Probe-B_SilkS.gbr, BoSL Probe-Edge_Cuts.gbr, BoSL Probe-F_Cu.gbr, BoSL Probe-F_Mask.gbr, BoSL Probe-F_Paste.gbr]
2019-11-19 changed water probe
    [Probe Body.blend]
2019-11-20 added images of sim7000 sim communitcation issue
    [Probe Body v8.stl, Probe Body.blend, Probe Body.stl, Probe Head.stl]
2019-11-21 SIM7000 sim communication issue report added begun on changes to EC probe body
    [Probe Body.blend]
2019-11-21 added test for probe head and body joint
    [F Probe Body.stl, F Probe Head.stl, Probe Body.blend, Probe Body.stl, Probe Head.stl]
2019-11-25 fixed water prove head-body joint to fit together when printed added BoSL test script for manufaturing QC added ping feature on bosl GPS to upload ping server when no GPS signal
    [F Probe Body.stl, F Probe Head.stl, Probe Body.blend, Probe Body.stl, Probe Head.stl]
2019-11-25 fixed bosl gps range threshold
    [BoSL-GPS.ino]
2019-11-27 added folder for velocity sensor
    [Probe Body.blend]
2019-11-27 Added AM demodulator Schematic
    [AM Demodulator.kicad_pcb, AM Demodulator.sch]
2019-11-27 added velocity AM demodulator gerbers
    [AM Demodulator-B_Cu.gbr, AM Demodulator-B_Mask.gbr, AM Demodulator-B_Paste.gbr, AM Demodulator-B_SilkS.gbr, AM Demodulator-Edge_Cuts.gbr, AM Demodulator-F_Cu.gbr, AM Demodulator-F_Mask.gbr, AM Demodulator-F_Paste.gbr]
2019-11-28 daily commit
    [AM Demodulator.sch]
2019-11-28 Added files for BoSL GPS Micro
    [BoSL_GSP_Micro.dsn, BoSL_GSP_Micro.kicad_pcb, BoSL_GSP_Micro.sch]
2019-11-28 started layout of micro bosl gps
    [BoSL_GSP_Micro.kicad_pcb, BoSL_GSP_Micro.sch]
2019-11-29 layout progress of gps micro board
    [BoSL_GSP_Micro.kicad_pcb, BoSL_GSP_Micro.sch]
2019-11-29 finished initial layout of BoSL GPS micro
    [BoSL_GSP_Micro.kicad_pcb]
2019-11-29 finished parts list for BoSL GPS Micro
    [BoSL_GSP_Micro.kicad_pcb, BoSL_GSP_Micro.sch]
2019-11-29 added bosl probe self test code
    [BoSL BOM Rev 0.3 GSP micro.xlsx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]
2019-12-01 added spi header to bosl GPS micro for bootloading
    [BoSL BOM Rev 0.3 GSP micro.xlsx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]
2019-12-01 added wait period for signal in GNSS code cleaner up some code repetition
    [BoSL_GSP_Micro.sch]
2019-12-01 fixed gps code bug, where did not check for fix
    [BoSL-GPS.ino]
2019-12-02 added battery voltage to bosl GPS transmit
2019-12-09 added oscilator for heterodyne circuit
    [AM Demodulator-B_Cu.gbr, AM Demodulator-B_Mask.gbr, AM Demodulator-B_Paste.gbr, AM Demodulator-B_SilkS.gbr, AM Demodulator-Edge_Cuts.gbr, AM Demodulator-F_Cu.gbr, AM Demodulator-F_Mask.gbr, AM Demodulator-F_Paste.gbr]
2019-12-10 added bosl velocity 3d caseing
    [Heterodyne.sch, Velocity Holder.blend, Velocity Holder.stl]
2019-12-11 made changes to bosl probe to improve fit with boards
    [F Probe Body.stl, F Probe Head.stl, Probe Body.blend, Probe Body.stl]
2019-12-11 added bosl code for bosl probe
2019-12-16 added bom and pcb files for velocity sensor
    [Heterodyne-B_Cu.gbr, Heterodyne-B_Mask.gbr, Heterodyne-B_Paste.gbr, Heterodyne-B_SilkS.gbr, Heterodyne-Edge_Cuts.gbr, Heterodyne-F_Cu.gbr, Heterodyne-F_Mask.gbr, Heterodyne-F_Paste.gbr]
2019-12-16 added bosllogo to allinone probe
    [Pressure Sensors.xlsx, Probe Body.blend]
2019-12-17 added links in bosl velocity bom
    [Probe Body.blend, Probe Body.stl, Velocity BOM.xlsx]
2019-12-18 added enhanced sleeping code for bosl
    [Velocity BOM.xlsx]
2019-12-19 began work on fault tollerant wire library
2019-12-20 added changes to bosl independant code notably created fucntion xDelay which sould be used in place of delay for power optimisations
2019-12-20 impimplemented xdelay and other power optimisation
2019-12-21 ammened partlist for all-in-one probe
    [BoSL-Probe BOM.xlsx]
2020-01-20 added top/bottom split to all in one probe
    [Probe Body.blend]
2020-01-20 added lip to bottom all in one probe
    [Probe Body.blend]
2020-01-20 all in one probe ready to be printed
    [Probe Body.blend]
2020-01-20 added 3d print files for bosl all in one probe
    [Probe Body.blend, Probe Body.stl, Probe Head.stl, Probe Top.stl]
2020-01-20 added supports for bosl probe casing
    [Probe Body.blend, Probe Body.stl, Probe Top.stl]
2020-01-21 added battery analysis excel spreadsheet for bosl endurance test
    [BOSL_BAT_70953.csv, Battery Data.xlsx]
2020-01-21 shrunk distance of overhang in bosl all in one casing
    [Probe Body.blend, Probe Body.stl, Probe Top.stl]
2020-01-21 added i2c bus immunity to prevent program from halting when a bad i2c device is plugged in. bosl_independant gives an error message when i2c not functioning correctly or absent
    [Probe Body.blend]
2020-01-22 changed up velocity heterodyne schematic to fix issues with wireing, and so provide a channel for sine wave driver amplification
    [Heterodyne.kicad_pcb, Heterodyne.sch]
2020-01-24 added error messages for no sensors on bosl independant added a 100% infull print mode for all-in-one probe
    [BoSL_Independant.ino]
2020-02-04 added updates to heterodyne code to take averages of multiple FFTs changed up heterodyne circuit to fix bugs
    [Analog Characterisations.xlsx, Heterodyne.sch]
2020-02-05 updated data to heterodyne pcb to include adc
    [Heterodyne.kicad_pcb, Heterodyne.sch, In Water Calibration.xlsx]
2020-02-05 finshsed routing 2 layer board
    [Heterodyne-B_Cu.gbr, Heterodyne-B_Mask.gbr, Heterodyne-B_Paste.gbr, Heterodyne-B_SilkS.gbr, Heterodyne-Edge_Cuts.gbr, Heterodyne-F_Cu.gbr, Heterodyne-F_Mask.gbr, Heterodyne-F_Paste.gbr]
2020-02-05 calibrated velocity, implemented multi sample rate rangeing
    [Heterodyne.kicad_pcb, Heterodyne.sch]
2020-02-07 added velocity testing data
    [Arduino Frequency Calibration.xlsx, Heterodyne.sch, In Water Multi Calibration.xlsx, PCB Dimentions.xlsx]
2020-02-10 added code for MAX11645 ADC on velocity
2020-02-10 changed heterodyne code to use MAX11645EUA+T heterodyne intervals calibrated
    [ADC FFT Calibration.xlsx, ADC Noise Calibration.xlsx]
2020-02-11 added dc removal on the FFT for velocity
    [ADC FFT Calibration.xlsx]
2020-02-13 added ATmega328P to velocity schematic
    [ADC FFT 3V3 Calibration.xlsx, ADC In Water 3.3V Calibration.xlsx, Heterodyne.kicad_pcb, Heterodyne.sch]
2020-02-14 added 4 layer PCB for heterodyne
    [Heterodyne-B_Cu.gbr, Heterodyne-B_Mask.gbr, Heterodyne-B_Paste.gbr, Heterodyne-B_SilkS.gbr, Heterodyne-Edge_Cuts.gbr, Heterodyne-F_Cu.gbr, Heterodyne-F_Mask.gbr, Heterodyne-F_Paste.gbr]
2020-02-16 added SPI out on velocity ATmega328P
    [Heterodyne.sch]
2020-02-20 added two layer version of the Heterodynbe PCB for laser cutting
    [Heterodyne-B_Cu.gbr, Heterodyne-B_Mask.gbr, Heterodyne-B_Paste.gbr, Heterodyne-B_SilkS.gbr, Heterodyne-Edge_Cuts.gbr, Heterodyne-F_Cu.gbr, Heterodyne-F_Mask.gbr, Heterodyne-F_Paste.gbr]
2020-02-21 added fusion 360 drill files for laser production
    [Heterodyne-B_Cu.gbr, Heterodyne-B_Mask.gbr, Heterodyne-B_Paste.gbr, Heterodyne-B_SilkS.gbr, Heterodyne-Edge_Cuts.gbr, Heterodyne-F_Cu.gbr, Heterodyne-F_Mask.gbr, Heterodyne-F_Paste.gbr]
2020-02-21 created fusion 360 drill file (external to repository)
    [PCB.stl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]
2020-02-27 fixed svg files for heterodyne pcb laser manufature
    [Heterodyne.kicad_pcb, PCB.stl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]
2020-02-27 fixed merge files with master
    [Heterodyne.kicad_pcb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]
2020-02-28 added velocity sensor 3d case
    [Heterodyne.kicad_pcb, Velocity.blend]
2020-02-28 added screw attachement method for two halves of velocity sensor casing
    [Velocity.blend]
2020-02-28 added modifed designs for laser heterodyne pcb
    [Heterodyne.kicad_pcb]
2020-03-09 added test for fix fft library
    [Velocity.blend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]
2020-03-09 isolated arduinoFFT library to work on
2020-03-09 added fix fft to heterodyne test file changed i2c library to be able to read more than 255 bytes at a time from device
    [I2C.cpp, I2C.h]
2020-03-09 increase sample numbers in heterodyne sketch to 256 adjusted all factors to have final number be the same: ToDo: check if the noise floor bin n = 2 is still good with double the samples ToDo: debug a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
2020-03-23 removed bosl velocity laser heterodyne circuit
    [Heterodyne.dsn, Heterodyne.kicad_pcb, Heterodyne.sch]
2020-03-23 organised velocity folder structure
    [AM Demodulator-B_Cu.gbr, AM Demodulator-B_Mask.gbr, AM Demodulator-B_Paste.gbr, AM Demodulator-B_SilkS.gbr, AM Demodulator-Edge_Cuts.gbr, AM Demodulator-F_Cu.gbr, AM Demodulator-F_Mask.gbr, AM Demodulator-F_Paste.gbr]
2020-03-24 added velocity casing for smaller tranducer
    [Velocity.blend, VelocitySmall.blend, Velocity_Back.stl, Velocity_Front.stl]
2020-04-05 added power on lines in heterodyne code for opamp and oscilator
    [VelocitySmall.blend]
2020-04-06 added i2c address for heterodyne ADC as macro
2020-04-08 fixed code hang in velocity code caused by bad uint8 to uint16 conversion in in i2c library
    [Heterodyne.kicad_pcb]
2020-04-13 switched ADC in velocity sensor from 2 V internal reference to 1V external referecnce in code
    [Velocity.blend, Velocity_Back.stl, Velocity_Front.stl]
2020-04-13 Velocity: changed supply for ADC ref voltage devider from VPP to arduino pin, est current saveings 1 mA
    [Heterodyne.sch]
2020-04-13 added STL files for small tranducer case and test holder
    [VelocityBACK.stl, VelocityFRONT.stl, VelocityQUICK.stl, VelocitySmall.blend]
2020-04-13 Velocity: 3d print tweek of small tranducer test
    [VelocityQUICK.stl, VelocitySmall.blend]
2020-04-14 added adjusted small tranducer test for bosl velocity
    [VelocityFRONT.stl, VelocitySmall.blend]
2020-04-14 velocity: added int16 related fixes for peak finding algorithm.
2020-04-14 Added changes to velocity small tranducer casing based on test fitting and mounting needs for field testing
    [BoSL Probe.sch, VelocityBACK.stl, VelocitySmall.blend]
2020-04-15 tweaked velocity casing
    [VelocityBACK.stl, VelocitySmall.blend]
2020-04-15 started work on bosl-bosl velocity interface code
2020-04-16 renamed bosl GPS to bosl
    [BoSL.kicad_pcb, BoSL.sch, BoSL_GSP.dsn, BoSL_GSP.kicad_pcb, BoSL_GSP.sch, BoSL_GSP_Micro.dsn, BoSL_GSP_Micro.kicad_pcb, BoSL_GSP_Micro.sch]
2020-04-16 begun layout of bosl board rev 0.4
    [BoSL.kicad_pcb, BoSL.sch]
2020-04-16 finished bosl board rev0.4 layout
    [BoSL BOM Rev 0.3 GSP micro.xlsx, BoSL BOM Rev 0.3 GSP.xlsx, BoSL BOM Rev 0.3.xlsx, BoSL.kicad_pcb, BoSL.sch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]
2020-04-17 added bugfixes to bosl-velocity protocal
    [Velocity.blend, VelocityBACK.stl, VelocityFRONT.stl, VelocityQUICK.stl, VelocitySmall.blend, Velocity_Back.stl, Velocity_Front.stl]
2020-04-18 added tweaks to velocity sensor casing
    [VelocityBACK.stl, VelocityFRONT.stl, VelocitySmall.blend]
2020-04-19 adding bosl bom
    [BoSL BOM Rev 0.4.xlsx, Velocity BOM.xlsx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]
2020-04-22 Working velocity code and corresponding bosl upload code
2020-04-22 added velocity case updates
    [VelocitySmall.blend]
2020-04-24 added update layout for bosl v4
    [BoSL.kicad_pcb, BoSL.sch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]
2020-04-29 added revision of bosl board
    [BoSL BOM Rev 0.4.xlsx, BoSL.kicad_pcb, BoSL.sch]
2020-04-30 updated 3d modles for bosl board
    [BoSL.kicad_pcb]
2020-05-02 added space savings of BoSL PCB
    [BoSL BOM Rev 0.4.xlsx, BoSL.kicad_pcb, BoSL.sch]
2020-05-04 updated bosl with small screw terminals
    [BoSL.kicad_pcb, BoSL.sch]
2020-05-04 finished bosl rev0.4
    [BoSL BOM Rev 0.4.xlsx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]
2020-05-08 removed averaging from velocity code
2020-05-11 added dandenong creek velocity testing samples
    [VELOCITY_SITE_TES.csv]
2020-05-11 changed velocity code to get 3 attempts to get amplitude > 1000
    [BoSL BOM Rev 0.4.xlsx]
2020-05-11 added updates to peak algorithm on velocity code
2020-08-11 clean for merge
    [ADC FFT 3V3 Calibration.xlsx, ADC FFT Calibration.xlsx, ADC In Water 3.3V Calibration.xlsx, ADC Noise Calibration.xlsx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]
2020-08-11 reorganised files
    [BOSL_BAT_70953.csv, Battery Calulator.xlsx, Battery Data.xlsx, BoSL BOM Rev 0.4.1.xlsx, BoSL Battery Log Test.xlsx, BoSL.dsn, BoSL.kicad_pcb, BoSL.sch]
